EarnshawSam/rpi-cm4-networked-carrier/hardware/rpi-cm4-base-carrier/cm4-base-carrier-brd.pdf

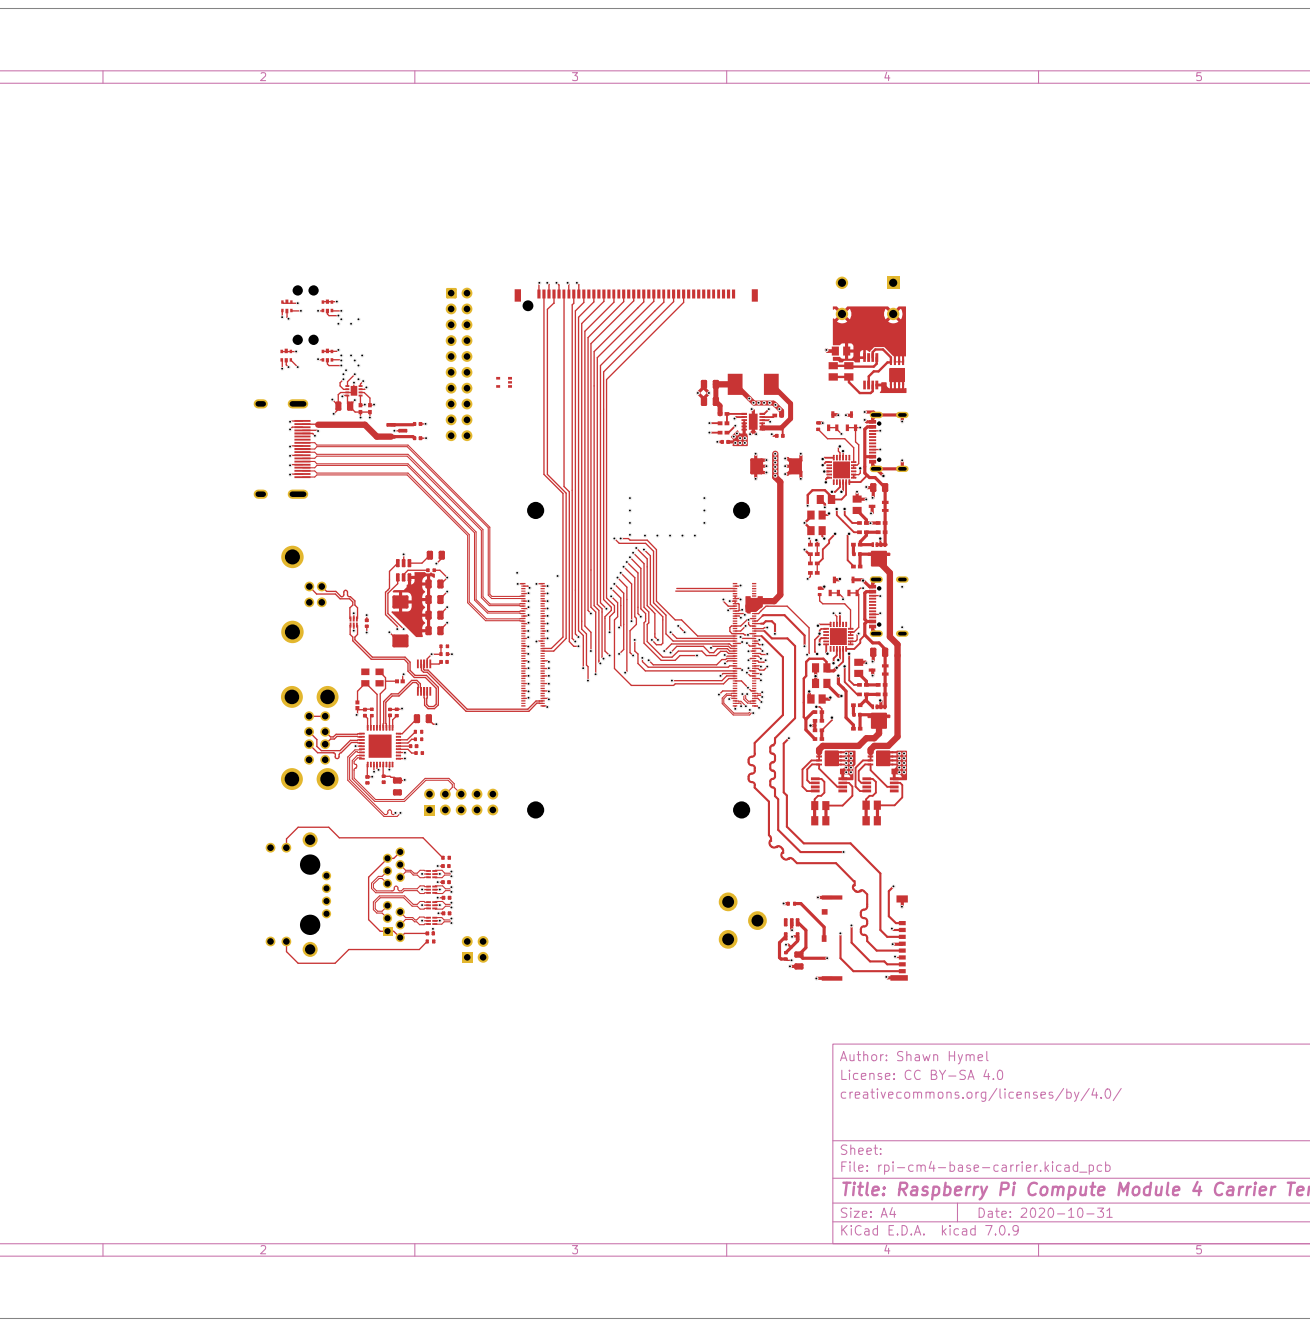
[picture p1: page 1]

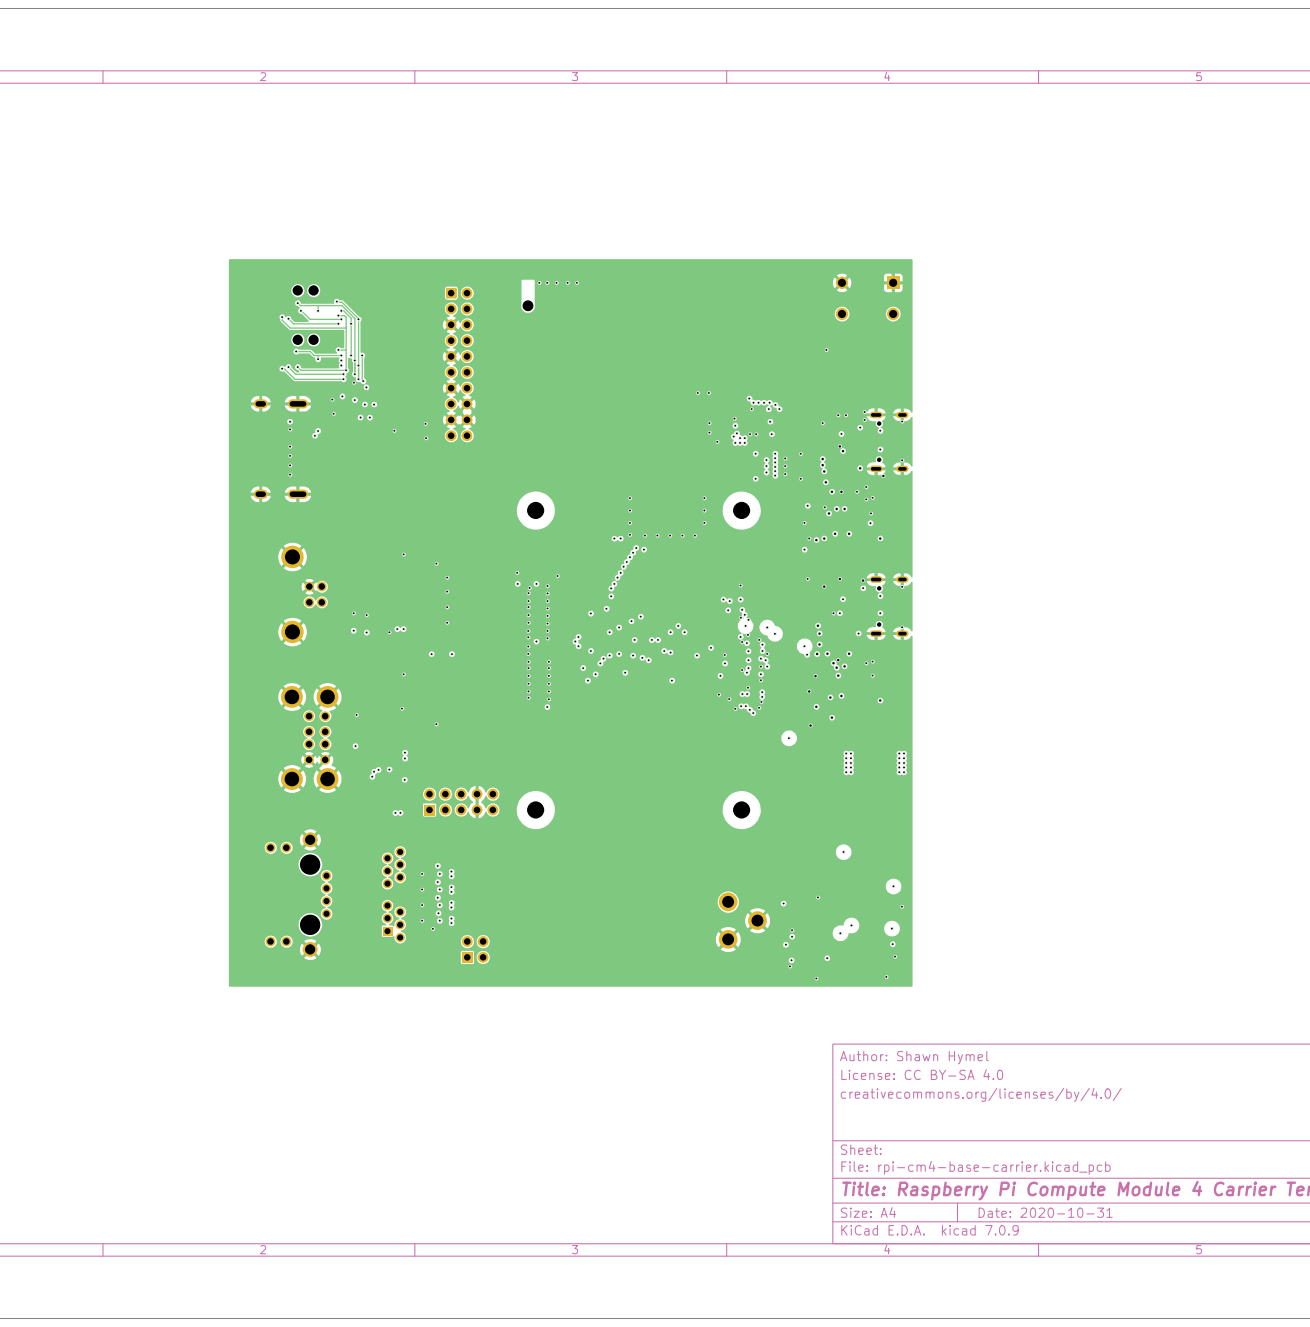
[picture p2: page 2]

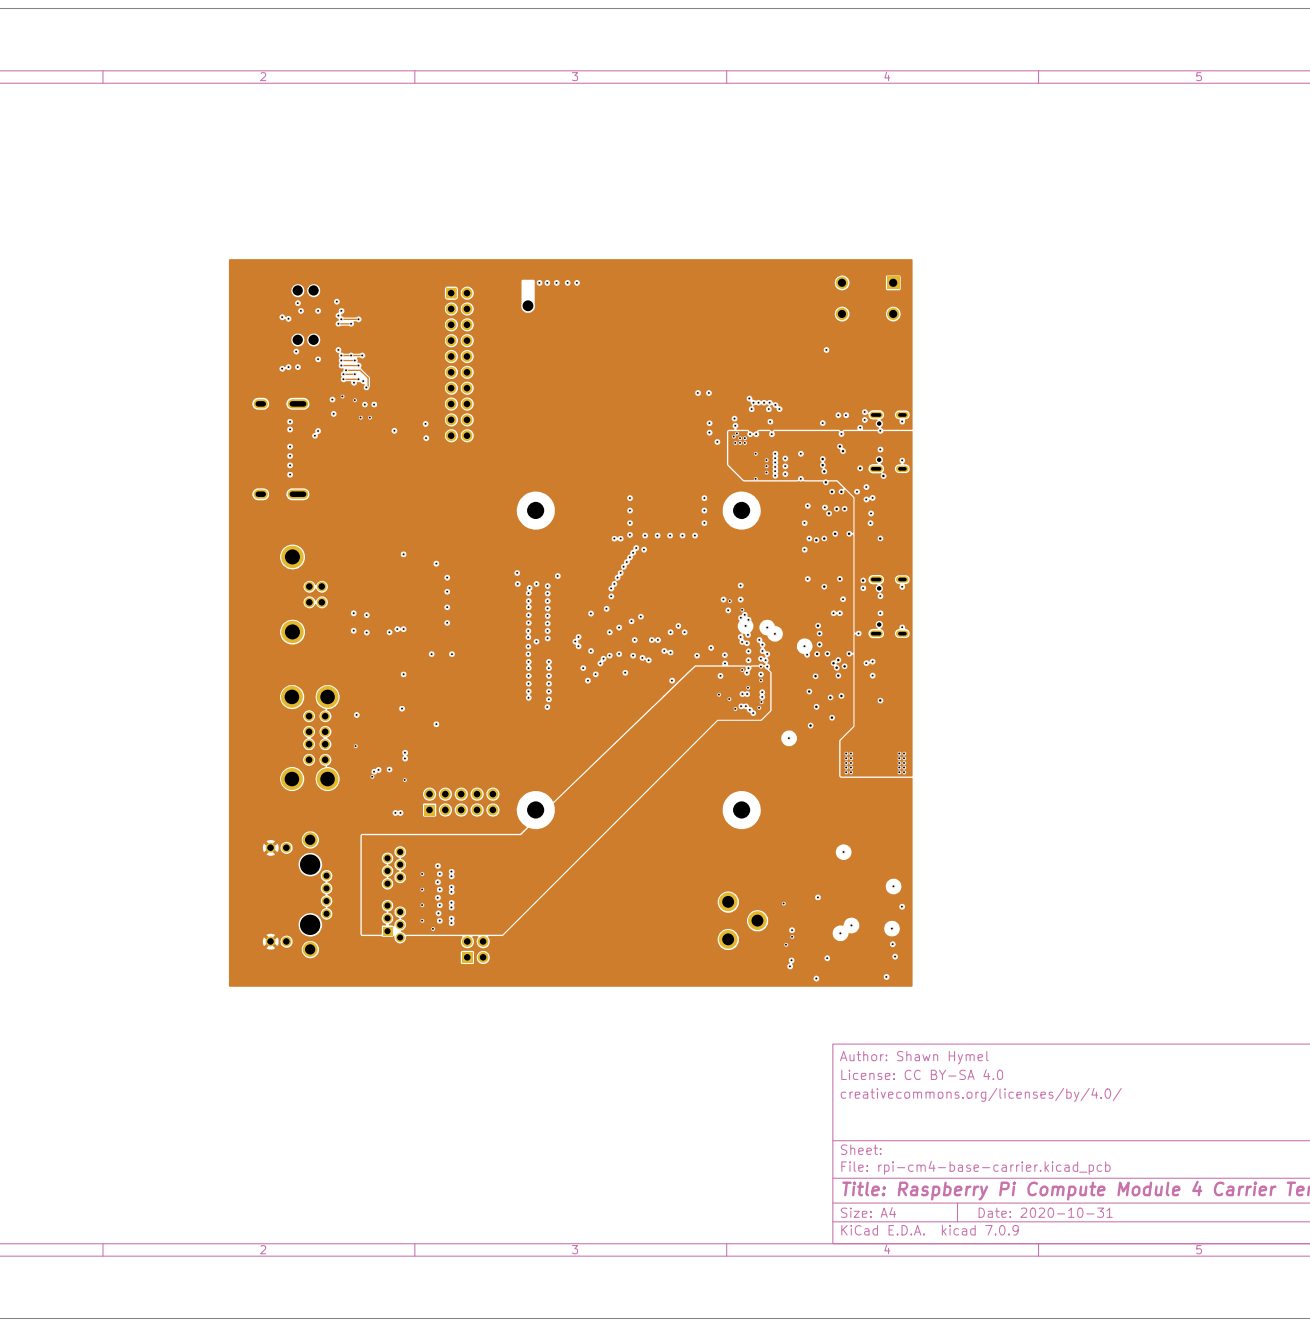
[picture p3: page 3]

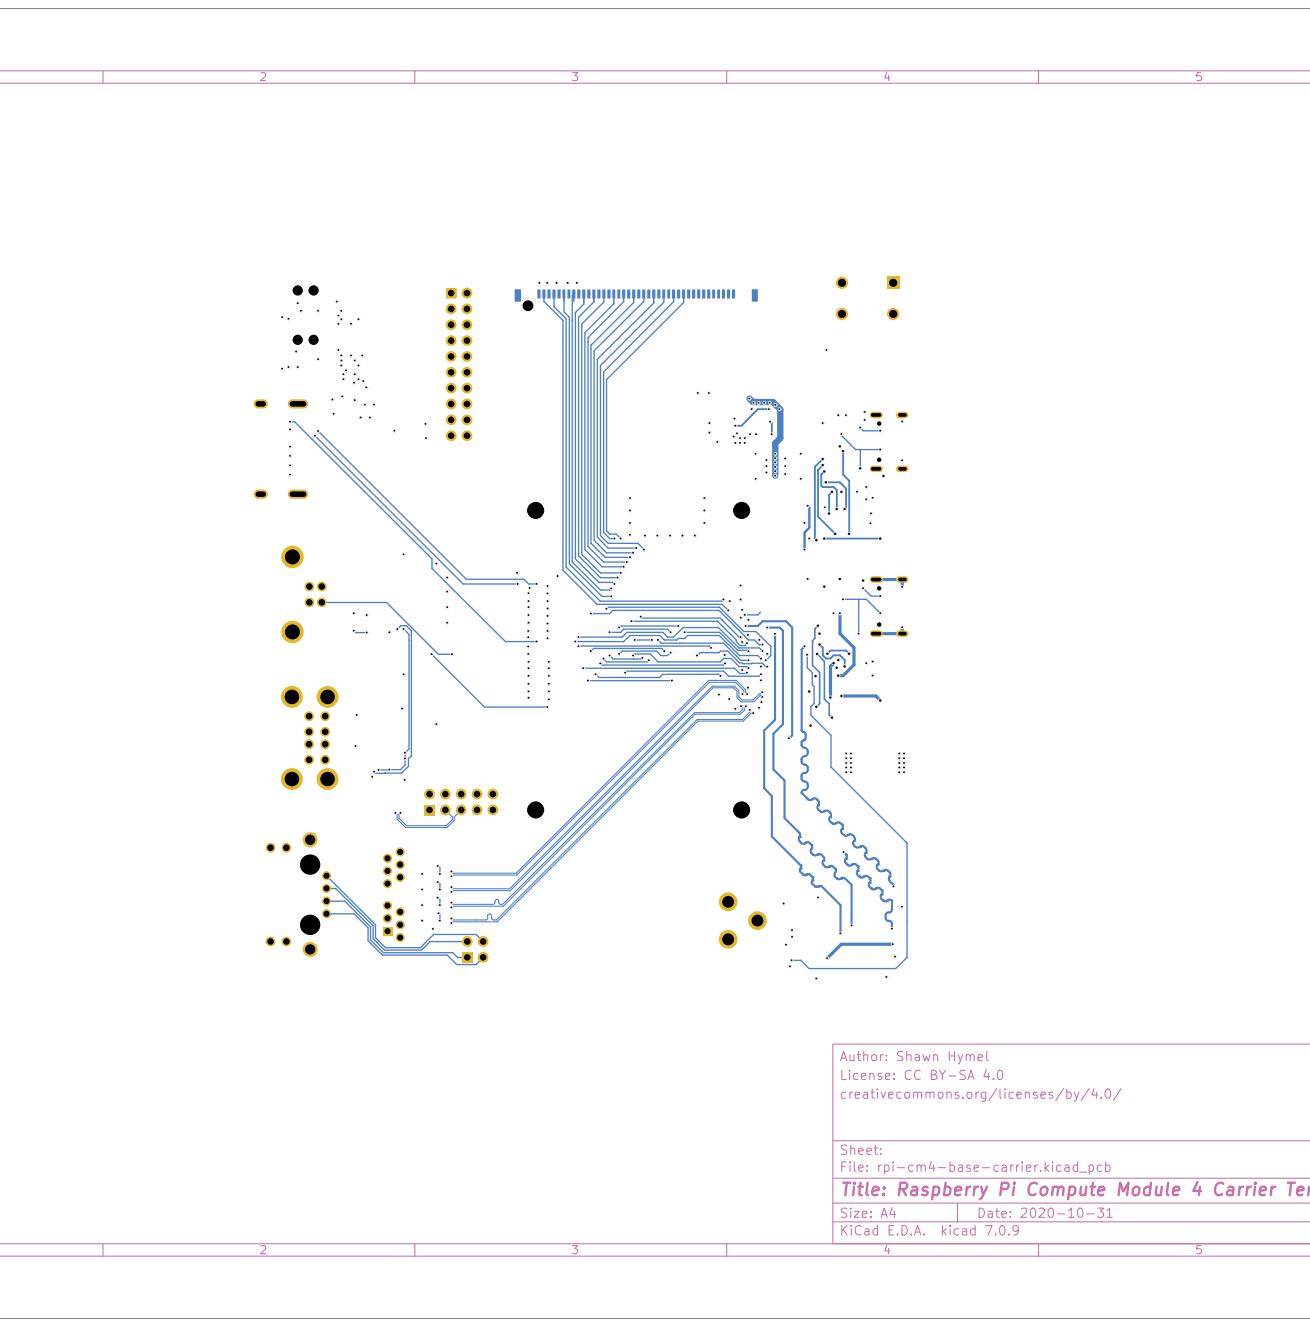
[picture p4: page 4]
