EarnshawSam/rpi-cm4-networked-carrier/hardware/rpi-cm4-base-carrier/rpi-cm4-base-carrier.kicad_pcb

## KiCad design hardware/rpi-cm4-base-carrier/rpi-cm4-base-carrier.kicad_pcb (2024-01-31)

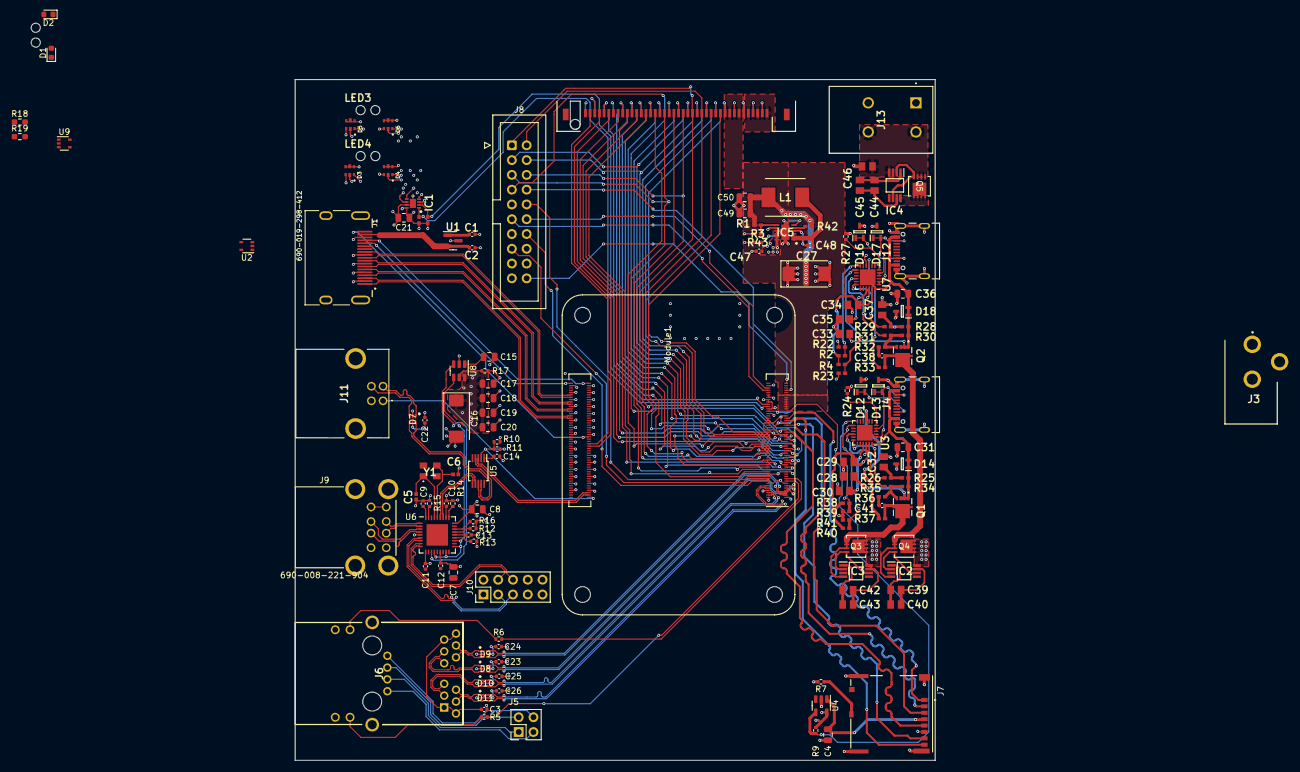
[picture p18: board rpi-cm4-base-carrier.kicad_pcb from above]

Board: 4 copper layers, 110.0 x 117.0 mm, 148 parts (1 on the bottom side), 168 nets.

Parts:
C1, C2, C3, C9, C10, C11, C12, C13, C14, C22, C23, C24, C25, C26, C38, C41, C47, C48: 100n; C_0402_1005Metric
C4, C7, C8, C15, C17, C18, C19, C20, C21, C31, C36, C49, C50: 10u; C_0805_2012Metric
C5, C6: 8pf; CAPC1005X56N
C16, C27: 100uF; CP_EIA-7343-31_Kemet-D
C28, C29, C30, C32, C33, C34, C35, C37, C39, C40, C42, C43, C44, C45, C46: 1u; RESC2012X140N
D1: LED Green; LED_0603_1608Metric
D2: LED Red; LED_0603_1608Metric
D3, D4, D5, D6: 19-337C_RSBHGHC-A88_4T; LED_19-337C_RSBHGHC-A88_4T
D7, D8, D9, D10, D11: USBULC6-2M6; SON50P100X145X60-6N-D
D12, D13, D14, D16, D17, D18: ESDA25W; SOT65P210X110-3N
IC1: KTD2052BEVAA-TR; SON50P200X200X58-9N
IC2, IC3, IC4: LM74610QDGKRQ1; SOP65P490X110-8N
IC5: LMR51450FNDRRR; SON50P300X300X80-13N-D
J1: 690-019-298-412; EDAC 690-019-298-412
J2: ERM8-040-01-X-D-EM2-L-XX; SAMTEC_ERM8-040-01-X-D-EM2-L-XX
J3: PJ-102BH; PJ-102AH
J4, J12: USB4105-GF-A; GCT_USB4105-GF-A
J5: THD-02-R; PinHeader_2x02_P2.54mm_Vertical
J6: JT4-1202HL; JT41202HL
J7: Micro_SD_Card_Det; SDCARD_MOLEX_503398-1892
J8: Conn_02x10_Odd_Even; IDC-Header_2x10_P2.54mm_Vertical
J9: 690-008-221-904; MOLEX_USB_67298-4090
J10: Conn_02x05_Odd_Even; PinHeader_2x05_P2.54mm_Vertical
J11: XM7B-0442; XM7B0442
J13: 1190297
L1: IHLP2525EZER2R2M01-2.2uH; INDPM6965X500N
LED1, LED2, LED3, LED4: 515-1114F
Module1: ComputeModule4-CM4; Raspberry-Pi-4-Compute-Module
Q1, Q2: STL6P3LLH6; TRANS_STL6P3LLH6
Q3, Q4, Q5: STL11N3LLH6; POWERFLAT_3P3X3P3_STM
R1, R30, R34, R42: 100K; RESC1005X40N
R2, R4, R38, R41: NF; RESC1005X40N
R3: 19K1; RESC1005X40N
R5, R6: 470R; R_0402_1005Metric
R7: nf; R_0402_1005Metric
R9, R15, R24, R27: 12K 1%; R_0402_1005Metric
R10, R11: 2.2K 1%; R_0402_1005Metric
R12, R13, R14, R16: 36K 1%; R_0402_1005Metric
R17: 15K 1%; R_0402_1005Metric
R18, R19: 1k; R_0603_1608Metric_Pad0.98x0.95mm_HandSolder
R20, R21: 4K7; RESC1005X37N
R22, R23, R31, R35, R39, R40: 22K; RESC1005X40N
R25, R28: 470R; RESC1005X40N
R26, R29, R33, R37: 1k; RESC1005X37N
R32, R36: 100R; RESC1005X40N
R43: 13K3; RESC1005X40N
U1: RT9742SNGV; SOT-23
U2, U9: 74LVC1G07SE-7; SOT-353_SC-70-5
U3, U7: STUSB4500QTR; QFN-24-1EP_4x4mm_P0.5mm_EP2.7x2.7mm
U4: RT9742GGJ5; SOT-23-5
U5: FSUSB42MUX; MSOP-10_3x3mm_P0.5mm
U6: USB2514B-I/M2; QFN-36-1EP_6x6mm_P0.5mm_EP3.7x3.7mm
U8: AP22653W6; SOT-23-6
Y1: CX3225CA24000D0HSSCC

Connections:
+1V8: Module1.88 (+1.8v_(Output)), Module1.90 (+1.8v_(Output))
+3V3: C7.1, C8.1, C9.1, C10.1, C11.1, C12.1, C13.1, C14.1, C21.1, D1.2 (A), D2.2 (A), IC1.8 (VIN), J2.63, J2.67, J6.18 (A_YELLOW), J6.20 (A_GREEN), Module1.78 (GPIO_VREF(1.8v/3.3v_Input)), Module1.84 (+3.3v_(Output)), Module1.86 (+3.3v_(Output)), R7.1, R9.1, R20.2, R21.2, U4.5 (IN), U5.1 (VCC), U6.5 (VDDA33), U6.10 (VDDA33), U6.15 (VDD33), U6.23 (VDD33), U6.27 (VBUS_DET), U6.29 (VDDA33), U6.36 (VDDA33), U9.5 (VCC)
+5V: C1.1, C15.1, C49.1, C50.1, J2.64, J2.68, L1.2, Module1.77 (+5v_(Input)), Module1.79 (+5v_(Input)), Module1.81 (+5v_(Input)), Module1.83 (+5v_(Input)), Module1.85 (+5v_(Input)), Module1.87 (+5v_(Input)), R1.1, R42.1, U1.1 (IN), U2.5 (VCC), U8.1 (IN)
+20V: C27.1, C47.1, IC2.8 (CATHODE), IC3.8 (CATHODE), IC4.8 (CATHODE), IC5.9 (EN), IC5.10 (VIN_1), IC5.11 (VIN_2), IC5.12 (VIN_3), J2.71, J2.72, J2.75, J2.76, J2.79, J2.80, Q3.5, Q3.6, Q3.7, Q3.8, Q4.5, Q4.6, Q4.7, Q4.8, Q5.5, Q5.6, Q5.7, Q5.8
/Board_Edge_Connector/AIN0: J8.11, Module1.94 (AnalogIP0)
/Board_Edge_Connector/AIN1: J8.12, Module1.96 (AnalogIP1)
/Board_Edge_Connector/EEPROM_nWP: J8.10, Module1.20 (EEPROM_nWP)
/Board_Edge_Connector/GLOBAL_EN: J8.20, Module1.99 (Global_EN)
/Board_Edge_Connector/GPIO2: J2.59, Module1.58 (GPIO2)
/Board_Edge_Connector/GPIO3: J2.60, Module1.56 (GPIO3)
/Board_Edge_Connector/GPIO4: J2.55, Module1.54 (GPIO4)
/Board_Edge_Connector/GPIO5: J2.56, Module1.34 (GPIO5)
/Board_Edge_Connector/GPIO6: J2.51, Module1.30 (GPIO6)
/Board_Edge_Connector/GPIO7: J2.52, J8.2, Module1.37 (GPIO7)
/Board_Edge_Connector/GPIO8: J2.47, J8.4, Module1.39 (GPIO8)
/Board_Edge_Connector/GPIO9: J2.48, J8.1, Module1.40 (GPIO9)
/Board_Edge_Connector/GPIO10: J2.43, J8.3, Module1.44 (GPIO10)
/Board_Edge_Connector/GPIO11: J2.44, J8.6, Module1.38 (GPIO11)
/Board_Edge_Connector/GPIO12: J2.39, Module1.31 (GPIO12)
/Board_Edge_Connector/GPIO13: J2.40, Module1.28 (GPIO13)
/Board_Edge_Connector/GPIO14: J2.35, J8.7, Module1.55 (GPIO14)
/Board_Edge_Connector/GPIO15: J2.36, J8.5, Module1.51 (GPIO15)
/Board_Edge_Connector/GPIO16: J2.31, Module1.29 (GPIO16)
/Board_Edge_Connector/GPIO17: J2.32, Module1.50 (GPIO17)
/Board_Edge_Connector/GPIO18: J2.27, Module1.49 (GPIO18)
/Board_Edge_Connector/GPIO19: J2.28, Module1.26 (GPIO19)
/Board_Edge_Connector/GPIO20: J2.23, Module1.27 (GPIO20)
/Board_Edge_Connector/GPIO21: J2.24, Module1.25 (GPIO21)
/Board_Edge_Connector/GPIO22: J2.19, Module1.46 (GPIO22)
/Board_Edge_Connector/GPIO23: J2.20, Module1.47 (GPIO23)
/Board_Edge_Connector/GPIO24: J2.15, Module1.45 (GPIO24)
/Board_Edge_Connector/GPIO25: J2.16, Module1.41 (GPIO25)
/Board_Edge_Connector/GPIO26: J2.11, Module1.24 (GPIO26)
/Board_Edge_Connector/GPIO27: J2.12, Module1.48 (GPIO27)
/Board_Edge_Connector/HDMI1_SCL: J2.04, Module1.147 (HDMI1_SCL)
/Board_Edge_Connector/HDMI1_SDA: J2.08, Module1.145 (HDMI1_SDA)
/Board_Edge_Connector/RUN_PG: Module1.92 (RUN_PG), U2.2
/Board_Edge_Connector/SYNC_IN: J8.14, Module1.16 (Ethernet_SYNC_IN(1.8v))
/Board_Edge_Connector/SYNC_OUT: J8.15, Module1.18 (Ethernet_SYNC_OUT(1.8v))
/Board_Edge_Connector/nRPIBOOT: J8.8, Module1.93 (nRPIBOOT)
/CM4 GPIO/ETH_LEDG: Module1.17 (Ethernet_nLED2(3.3v)), R6.2
/CM4 GPIO/ETH_LEDY: Module1.15 (Ethernet_nLED3(3.3v)), R5.2
/CM4 GPIO/LEDs/RGB1: D3.5, D4.3, D5.1, D6.2, D6.4, D6.6, IC1.6 (LED1)
/CM4 GPIO/LEDs/RGB2: D3.3, D4.1, D5.2, D5.4, D5.6, D6.5, IC1.5 (LED2)
/CM4 GPIO/LEDs/RGB3: D3.1, D4.2, D4.4, D4.6, D5.5, D6.3, IC1.3 (LED4)
/CM4 GPIO/LEDs/RGB4: D3.2, D3.4, D3.6, D4.5, D5.3, D6.1, IC1.4 (LED3)
/CM4 GPIO/SCL0: IC1.1 (SCL), J2.03, Module1.80 (SCL0), R20.1, U3.7 (SCL), U7.7 (SCL)
/CM4 GPIO/SDA0: IC1.2 (SDA), J2.07, Module1.82 (SDA0), R21.1, U3.8 (SDA), U7.8 (SDA)
/CM4 GPIO/SD_CLK: J7.5 (CLK), Module1.57 (SD_CLK)
/CM4 GPIO/SD_CMD: J7.3 (CMD), Module1.62 (SD_CMD)
/CM4 GPIO/SD_DAT0: J7.7 (DAT0), Module1.63 (SD_DAT0)
/CM4 GPIO/SD_DAT1: J7.8 (DAT1), Module1.67 (SD_DAT1)
/CM4 GPIO/SD_DAT2: J7.1 (DAT2), Module1.69 (SD_DAT2)
/CM4 GPIO/SD_DAT3: J7.2 (DAT3/CD), Module1.61 (SD_DAT3)
/CM4 GPIO/SD_PWR_ON: Module1.75 (SD_PWR_ON), R9.2, U4.4 (EN)
/CM4 GPIO/TRD0_N: D11.1 (D+), D11.6 (I/O1), J6.9 (TRD1-), Module1.10 (Ethernet_Pair0_N)
/CM4 GPIO/TRD0_P: D11.3 (D-), D11.4 (I/O2), J6.8 (TRD1+), Module1.12 (Ethernet_Pair0_P)
/CM4 GPIO/TRD1_N: D10.3 (D-), D10.4 (I/O2), J6.3 (TRD2-), Module1.6 (Ethernet_Pair1_N)
/CM4 GPIO/TRD1_P: D10.1 (D+), D10.6 (I/O1), J6.2 (TRD2+), Module1.4 (Ethernet_Pair1_P)
/CM4 GPIO/TRD2_N: D8.3 (D-), D8.4 (I/O2), J6.5 (TRD3-), Module1.9 (Ethernet_Pair2_N)
/CM4 GPIO/TRD2_P: D8.1 (D+), D8.6 (I/O1), J6.4 (TRD3+), Module1.11 (Ethernet_Pair2_P)
/CM4 GPIO/TRD3_N: D9.1 (D+), D9.6 (I/O1), J6.11 (TRD4-), Module1.5 (Ethernet_Pair3_N)
/CM4 GPIO/TRD3_P: D9.3 (D-), D9.4 (I/O2), J6.10 (TRD4+), Module1.3 (Ethernet_Pair3_P)
/CM4 GPIO/nLED_Activity: Module1.21 (PI_nLED_Activity), R18.2
/CM4 GPIO/nPWR_LED: Module1.95 (nPI_LED_PWR), U9.2
/CM4 High Speed/HDMI0_CK_N: J1.12 (CK-), Module1.190 (HDMI0_CLK_N)
/CM4 High Speed/HDMI0_CK_P: J1.10 (CK+), Module1.188 (HDMI0_CLK_P)
/CM4 High Speed/HDMI0_D0_N: J1.9 (D0-), Module1.184 (HDMI0_TX0_N)
/CM4 High Speed/HDMI0_D0_P: J1.7 (D0+), Module1.182 (HDMI0_TX0_P)
/CM4 High Speed/HDMI0_D1_N: J1.6 (D1-), Module1.178 (HDMI0_TX1_N)
/CM4 High Speed/HDMI0_D1_P: J1.4 (D1+), Module1.176 (HDMI0_TX1_P)
/CM4 High Speed/HDMI0_D2_N: J1.3 (D2-), Module1.172 (HDMI0_TX2_N)
/CM4 High Speed/HDMI0_D2_P: J1.1 (D2+), Module1.170 (HDMI0_TX2_P)
/CM4 High Speed/HDMI0_HOTPLUG: J1.19 (HPD/HEAC-), Module1.153 (HDMI0_HOTPLUG)
/CM4 High Speed/HDMI0_SCL: J1.15 (SCL), Module1.200 (HDMI0_SCL)
/CM4 High Speed/HDMI0_SDA: J1.16 (SDA), Module1.199 (HDMI0_SDA)
/CM4 High Speed/HDMI/HDMI_5v: C2.1, J1.18 (+5V), U1.2 (OUT)
/CM4 High Speed/USB2-HUB/HD1_N: J9.2 (D-`), U6.1 (USBDM_DN1/PRT_DIS_M1)
/CM4 High Speed/USB2-HUB/HD1_P: J9.3 (D+`), U6.2 (USBDP_DN1/PRT_DIS_P1)
/CM4 High Speed/USB2-HUB/HD2_N: J9.6 (D-), U6.3 (USBDM_DN2/PRT_DIS_M2)
/CM4 High Speed/USB2-HUB/HD2_P: J9.7 (D+), U6.4 (USBDP_DN2/PRT_DIS_P2)
/CM4 High Speed/USB2-HUB/HD3_N: J10.3, U6.6 (USBDM_DN3/PRT_DIS_M3)
/CM4 High Speed/USB2-HUB/HD3_P: J10.5, U6.7 (USBDP_DN3/PRT_DIS_P3)
/CM4 High Speed/USB2-HUB/HD4_N: J10.4, U6.8 (USBDM_DN4/PRT_DIS_M4)
/CM4 High Speed/USB2-HUB/HD4_P: J10.6, U6.9 (USBDP_DN4/PRT_DIS_P4)
/CM4 High Speed/USB2-HUB/PWR1: U6.12 (PRTPWR1/BC_EN1), U8.3 (EN)
/CM4 High Speed/USB2-HUB/USBD_N: D7.1 (D+), D7.6 (I/O1), J11.2, U5.8 (HSD1_M)
/CM4 High Speed/USB2-HUB/USBH_N: U5.6 (HSD0_M), U6.30 (USBDM_UP)
/CM4 High Speed/USB2-HUB/USBH_P: U5.7 (HSD0_P), U6.31 (USBDP_UP)
/CM4 High Speed/USB2-HUB/VBUS: C16.1, C17.1, C18.1, C19.1, C20.1, J9.1 (VBUS`), J9.5 (VBUS), J10.1, J10.2, U8.6 (OUT)
/CM4 High Speed/USB2-HUB/nEXTRST: Module1.100 (nEXTRST), U6.26 (RESET_N)
/CM4 High Speed/USB2-HUB/nOCS1: U6.13 (OCS_N1), U6.17 (OCS_N2), U6.19 (OCS_N3), U6.21 (OCS_N4), U8.4 (nFault)
/CM4 High Speed/USB2_N: Module1.103 (USB2_N), U5.4 (D_N)
/CM4 High Speed/USB2_P: Module1.105 (USB2_P), U5.3 (D_P)
/CM4 High Speed/USB_OTG_ID: Module1.101 (USB_OTG_ID), R10.1, R11.2, U5.2 (SEL)
/Power_Input/AUX_20V: C46.1, IC4.4 (ANODE), J3.1, J13.3 (2.1), J13.4 (2.2), Q5.1, Q5.2, Q5.3
/Power_Input/USBC_PWR.Sheet1/+2V7: C29.1, R38.1, R40.1, U3.23 (VREG_2V7)
/Power_Input/USBC_PWR.Sheet1/ADDR0: R38.2, R39.1, U3.12 (ADDR0)
/Power_Input/USBC_PWR.Sheet1/ADDR1: R40.2, R41.1, U3.13 (ADDR1)
/Power_Input/USBC_PWR.Sheet1/CC1: D12.1 (CATHODE_1), D12.2 (CATHODE_2), J4.A5 (CC1), U3.1 (CC1DB), U3.2 (CC1)
/Power_Input/USBC_PWR.Sheet1/CC2: D13.1 (CATHODE_1), D13.2 (CATHODE_2), J4.B5 (CC2), U3.4 (CC2), U3.5 (CC2DB)
/Power_Input/USBC_PWR.Sheet1/V_SINK: C41.1, IC3.4 (ANODE), Q1.5_8 (5), Q3.1, Q3.2, Q3.3, R37.1
/Power_Input/USBC_PWR.Sheet/+2V7: C34.1, R2.1, R4.1, U7.23 (VREG_2V7)
/Power_Input/USBC_PWR.Sheet/ADDR0: R2.2, R22.1, U7.12 (ADDR0)
/Power_Input/USBC_PWR.Sheet/ADDR1: R4.2, R23.1, U7.13 (ADDR1)
/Power_Input/USBC_PWR.Sheet/CC1: D16.1 (CATHODE_1), D16.2 (CATHODE_2), J12.A5 (CC1), U7.1 (CC1DB), U7.2 (CC1)
/Power_Input/USBC_PWR.Sheet/CC2: D17.1 (CATHODE_1), D17.2 (CATHODE_2), J12.B5 (CC2), U7.4 (CC2), U7.5 (CC2DB)
/Power_Input/USBC_PWR.Sheet/V_SINK: C38.1, IC2.4 (ANODE), Q2.5_8 (5), Q4.1, Q4.2, Q4.3, R33.1
/SDCard/SD_PWR: C4.1, J7.4 (VDD), U4.1 (OUT)
/magjack/TR0_TAP: J5.3, J6.13 (TRP1)
/magjack/TR1_TAP: J5.1, J6.14 (TRP2)
/magjack/TR2_TAP: J5.2, J6.15 (TRP3)
/magjack/TR3_TAP: J5.4, J6.16 (TRP4)
/magjack/TRCT: C3.1, J6.1 (TRCT2), J6.6 (TRCT3), J6.7 (TRCT1), J6.12 (TRCT4)
GND: C1.2, C2.2, C3.2, C4.2, C5.2, C6.2, C7.2, C8.2, C9.2, C10.2, C11.2, C12.2, C13.2, C14.2, C15.2, C16.2, C17.2, C18.2, C19.2, C20.2, C21.2, C22.2, C23.2, C24.2, C25.2, C26.2, C27.2, C28.2, C29.2, C30.2, C31.2, C32.2, C33.2, C34.2, C35.2, C36.2, C37.2, C46.2, C47.2, C49.2, C50.2, D7.2 (GND_1), D7.4 (I/O2), D8.2 (GND_1), D9.2 (GND_1), D10.2 (GND_1), D11.2 (GND_1), D12.3 (ANODE), D13.3 (ANODE), D14.3 (ANODE), D16.3 (ANODE), D17.3 (ANODE), D18.3 (ANODE), IC1.7 (GND), IC1.9 (EP), IC5.8 (AGND), IC5.13 (PGND/DAP), J1.2 (D2S), J1.5 (D1S), J1.8 (D0S), J1.11 (CKS), J1.17 (GND), J1.SH1 (SH), J1.SH2 (SH), J1.SH3 (SH), J1.SH4 (SH), J2.01, J2.02, J2.05, J2.06, J2.09, J2.10, J2.13, J2.14, J2.17, J2.18, J2.21, J2.22, J2.25, J2.26, J2.29, J2.30, J2.33, J2.34, J2.37, J2.38, J2.41, J2.42, J2.45, J2.46, J2.49, J2.50, J2.53, J2.54, J2.57, J2.58, J2.61, J2.62, J2.65, J2.66, J2.69, J2.70, J2.73, J2.74, J2.77, J2.78, J3.2, J3.3, J4.A1/B12 (GND), J4.B1/A12 (GND), J4.G1 (GND), J4.G2 (GND), J4.G3 (GND), J4.G4 (GND), J6.MH3, J6.MH4, J7.6 (VSS), J7.11 (SHIELD), J8.9, J8.13, J8.16, J8.17, J8.18, J9.4 (GND`), J9.8 (GND), J9.MT1, J9.MT2, J9.MT3, J9.MT4, J10.7, J10.8, J11.3, J11.MH1, J11.MH2, J12.A1/B12 (GND), J12.B1/A12 (GND), J12.G1 (GND), J12.G2 (GND), J12.G3 (GND), J12.G4 (GND), J13.1 (1.1), J13.2 (1.2), Module1.1 (GND), Module1.2 (GND), Module1.7 (GND), Module1.8 (GND), Module1.13 (GND), Module1.14 (GND), Module1.22 (GND), Module1.23 (GND), Module1.32 (GND), Module1.33 (GND), Module1.42 (GND), Module1.43 (GND), Module1.52 (GND), Module1.53 (GND), Module1.59 (GND), Module1.60 (GND), Module1.65 (GND), Module1.66 (GND), Module1.71 (GND), Module1.74 (GND), Module1.98 (GND), Module1.107 (GND), Module1.108 (GND), Module1.113 (GND), Module1.114 (GND), Module1.119 (GND), Module1.120 (GND), Module1.125 (GND), Module1.126 (GND), Module1.131 (GND), Module1.132 (GND), Module1.137 (GND), Module1.138 (GND), Module1.144 (GND), Module1.150 (GND), Module1.155 (GND), Module1.156 (GND), Module1.161 (GND), Module1.162 (GND), Module1.167 (GND), Module1.168 (GND), Module1.173 (GND), Module1.174 (GND), Module1.179 (GND), Module1.180 (GND), Module1.185 (GND), Module1.186 (GND), Module1.191 (GND), Module1.192 (GND), Module1.197 (GND), Module1.198 (GND), R3.1, R10.2, R12.2, R13.2, R14.2, R15.1, R16.2, R17.2, R22.2, R23.2, R24.1, R27.1, R39.2, R41.2, R43.1, U1.3 (GND), U2.3 (GND), U3.10 (GND), U3.22 (VSYS), U3.25 (GND), U4.2 (GND), U5.5 (GND), U5.9 (HSD1_P), U5.10 (nOE), U6.37 (VSS), U7.10 (GND), U7.22 (VSYS), U7.25 (GND), U8.2 (GND), U9.3 (GND)
unnamed: C32.1, R25.2, R26.1
unnamed: C37.1, R28.2, R29.1
unnamed: C38.2, R32.2
unnamed: C41.2, R36.2
unnamed: D1.1 (K), R18.1
unnamed: D2.1 (K), R19.1
unnamed: C22.1, D7.5 (GND_2)
unnamed: C23.1, D8.5 (GND_2)
unnamed: C24.1, D9.5 (GND_2)
unnamed: C25.1, D10.5 (GND_2)
unnamed: C26.1, D11.5 (GND_2)
unnamed: C28.1, C31.1, D14.1 (CATHODE_1), D14.2 (CATHODE_2), J4.A4/B9 (VBUS), J4.B4/A9 (VBUS), Q1.1, Q1.2, Q1.3, R25.1, R34.1, U3.24 (VDD)
unnamed: C33.1, C36.1, D18.1 (CATHODE_1), D18.2 (CATHODE_2), J12.A4/B9 (VBUS), J12.B4/A9 (VBUS), Q2.1, Q2.2, Q2.3, R28.1, R30.1, U7.24 (VDD)
unnamed: IC2.2 (GATE_PULL_DOWN), IC2.6 (GATE_DRIVE), Q4.4
unnamed: C39.2, C40.2, IC2.7 (VCAPH)
unnamed: C39.1, C40.1, IC2.1 (VCAPL)
unnamed: IC3.2 (GATE_PULL_DOWN), IC3.6 (GATE_DRIVE), Q3.4
unnamed: C42.2, C43.2, IC3.7 (VCAPH)
unnamed: C42.1, C43.1, IC3.1 (VCAPL)
unnamed: IC4.2 (GATE_PULL_DOWN), IC4.6 (GATE_DRIVE), Q5.4
unnamed: C44.2, C45.2, IC4.7 (VCAPH)
unnamed: C44.1, C45.1, IC4.1 (VCAPL)
unnamed: C48.1, IC5.4 (BOOT)
unnamed: IC5.7 (FB), R1.2, R3.2
unnamed: IC5.5 (PG), R42.2
unnamed: IC5.6 (RT), R43.2
unnamed: C48.2, IC5.1 (SW_1), IC5.2 (SW_2), IC5.3 (SW_3), L1.1
unnamed: J6.19 (K_GREEN), R6.1
unnamed: J6.17 (K_YELLOW), R5.1
unnamed: J7.10 (DET_A), R7.2
unnamed: J8.19, U2.4
unnamed: J11.1, R11.1
unnamed: Q1.4, R34.2, R35.1, R36.1
unnamed: Q2.4, R30.2, R31.1, R32.1
unnamed: R19.2, U9.4
unnamed: R37.2, U3.9 (DISCH)
unnamed: R24.2, U3.6 (RESET)
unnamed: R35.2, U3.16 (VBUS_EN_SNK)
unnamed: R26.2, U3.18 (VBUS_VS_DISCH)
unnamed: C30.1, U3.21 (VREG_1V2)
unnamed: R16.1, U6.25 (HS_IND/CFG_SEL1)
unnamed: R15.2, U6.35 (RBIAS)
unnamed: R12.1, U6.24 (SCL/SMBCLK/CFG_SEL0)
unnamed: R13.1, U6.22 (SDA/SMBDATA/NON_REM1)
unnamed: R14.1, U6.28 (SUSP_IND/LOCAL_PWR/NON_REM0)
unnamed: C5.1, U6.33 (XTALIN/CLKIN), Y1.1 (HOT_1)
unnamed: C6.1, U6.32 (XTALOUT), Y1.3 (HOT_2)
unnamed: R33.2, U7.9 (DISCH)
unnamed: R27.2, U7.6 (RESET)
unnamed: R31.2, U7.16 (VBUS_EN_SNK)
unnamed: R29.2, U7.18 (VBUS_VS_DISCH)
unnamed: C35.1, U7.21 (VREG_1V2)
unnamed: R17.1, U8.5 (ILIM)
