EarnshawSam/rpi-cm4-networked-carrier/hardware/rpi-cm4-base-carrier/rpi-cm4-base-carrier - Backup.kicad_pcb

## KiCad design hardware/rpi-cm4-base-carrier/rpi-cm4-base-carrier - Backup.kicad_pcb (2024-01-14)

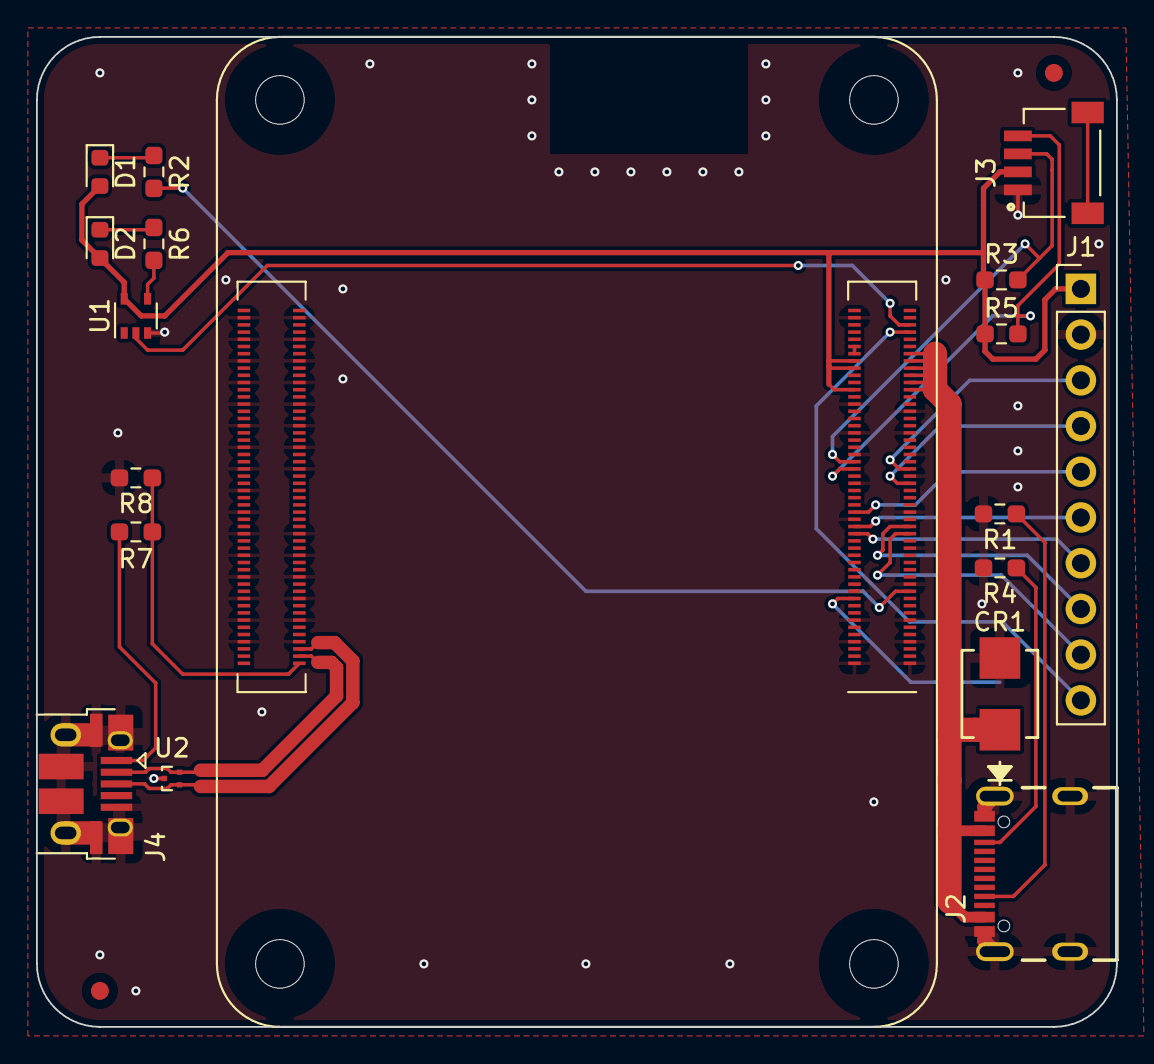
[picture p19: board rpi-cm4-base-carrier - Backup.kicad_pcb from above]

Board: 2 copper layers, 60.0 x 55.0 mm, 19 parts (1 on the bottom side), 27 nets.

Parts:
CR1: SMBJ5.0A-TR
D1: LED Green; LED_0603_1608Metric
D2: LED Red; LED_0603_1608Metric
J1: DNP; PinHeader_1x10_P2.54mm_Vertical
J2: USB4105-GF-A; GCT_USB4105-GF-A
J3: SM04B-SRSS-TB(LF)(SN); JST_SM04B-SRSS-TB(LF)(SN)
J4: USB_OTG; USB_Micro-B_EDAC_UCON00686
JP1: SolderJumper_2_Open; SolderJumper-2_P1.3mm_Open_RoundedPad1.0x1.5mm
Module1: ComputeModule4-CM4; Raspberry-Pi-4-Compute-Module
R1, R4: 5.1k; R_0603_1608Metric_Pad0.98x0.95mm_HandSolder
R2, R6: 1k; R_0603_1608Metric_Pad0.98x0.95mm_HandSolder
R3, R5: DNP; R_0603_1608Metric_Pad0.98x0.95mm_HandSolder
R7, R8: 2.2K 1%; R_0603_1608Metric_Pad0.98x0.95mm_HandSolder
U1: 74LVC1G07SE-7; SOT-353_SC-70-5
U2: TPD2EUSB30; Texas_DRT-3

Connections:
+1.8V: Module1.88 (+1.8v_(Output)), Module1.90 (+1.8v_(Output))
+3.3V: D1.2 (A), D2.2 (A), J1.1, J3.2, Module1.78 (GPIO_VREF(1.8v/3.3v_Input)), Module1.84 (+3.3v_(Output)), Module1.86 (+3.3v_(Output)), R3.1, R5.1, U1.5 (VCC)
+5V: CR1.1, J2.A4/B9 (VBUS), J2.B4/A9 (VBUS), Module1.77 (+5v_(Input)), Module1.79 (+5v_(Input)), Module1.81 (+5v_(Input)), Module1.83 (+5v_(Input)), Module1.85 (+5v_(Input)), Module1.87 (+5v_(Input))
/CM4 GPIO/EEPROM_nWP: JP1.1 (A), Module1.20 (EEPROM_nWP)
/CM4 GPIO/GPIO2: J3.3, Module1.58 (GPIO2), R3.2
/CM4 GPIO/GPIO3: J3.4, Module1.56 (GPIO3), R5.2
/CM4 GPIO/GPIO7: J1.9, Module1.37 (GPIO7)
/CM4 GPIO/GPIO8: J1.8, Module1.39 (GPIO8)
/CM4 GPIO/GPIO9: J1.6, Module1.40 (GPIO9)
/CM4 GPIO/GPIO10: J1.5, Module1.44 (GPIO10)
/CM4 GPIO/GPIO11: J1.7, Module1.38 (GPIO11)
/CM4 GPIO/GPIO14: J1.3, Module1.55 (GPIO14)
/CM4 GPIO/GPIO15: J1.4, Module1.51 (GPIO15)
/CM4 GPIO/nLED_Activity: Module1.21 (PI_nLED_Activity), R2.2
/CM4 GPIO/nPWR_LED: Module1.95 (nPI_LED_PWR), U1.2
/CM4 GPIO/nRPIBOOT: J1.10, Module1.93 (nRPIBOOT)
/CM4 High Speed/USB2_N: J4.2 (D-), Module1.103 (USB2_N), U2.2 (D-)
/CM4 High Speed/USB2_P: J4.3 (D+), Module1.105 (USB2_P), U2.1 (D+)
/CM4 High Speed/USB_OTG_ID: Module1.101 (USB_OTG_ID), R7.2, R8.1
GND: CR1.2, J1.2, J2.A1/B12 (GND), J2.B1/A12 (GND), J2.G1 (GND), J2.G2 (GND), J2.G3 (GND), J2.G4 (GND), J3.1, J4.5 (GND), J4.6 (Shield), JP1.2 (B), Module1.1 (GND), Module1.2 (GND), Module1.7 (GND), Module1.8 (GND), Module1.13 (GND), Module1.14 (GND), Module1.22 (GND), Module1.23 (GND), Module1.32 (GND), Module1.33 (GND), Module1.42 (GND), Module1.43 (GND), Module1.52 (GND), Module1.53 (GND), Module1.59 (GND), Module1.60 (GND), Module1.65 (GND), Module1.66 (GND), Module1.71 (GND), Module1.74 (GND), Module1.98 (GND), Module1.107 (GND), Module1.108 (GND), Module1.113 (GND), Module1.114 (GND), Module1.119 (GND), Module1.120 (GND), Module1.125 (GND), Module1.126 (GND), Module1.131 (GND), Module1.132 (GND), Module1.137 (GND), Module1.138 (GND), Module1.144 (GND), Module1.150 (GND), Module1.155 (GND), Module1.156 (GND), Module1.161 (GND), Module1.162 (GND), Module1.167 (GND), Module1.168 (GND), Module1.173 (GND), Module1.174 (GND), Module1.179 (GND), Module1.180 (GND), Module1.185 (GND), Module1.186 (GND), Module1.191 (GND), Module1.192 (GND), Module1.197 (GND), Module1.198 (GND), R1.2, R4.2, R8.2, U1.3 (GND), U2.3 (GND)
unnamed: D1.1 (K), R2.1
unnamed: D2.1 (K), R6.1
unnamed: J2.A5 (CC1), R1.1
unnamed: J2.B5 (CC2), R4.1
unnamed: J3.S1 (SHIELD), J3.S2 (SHIELD)
unnamed: J4.1 (VBUS), R7.1
unnamed: R6.2, U1.4
