EarnshawSam/rpi-cm4-networked-carrier/(commit log)

2024-01-13 schematic changes to add network, hdmi, usbhost and SD
    [HDMI.kicad_sch, SDCard.kicad_sch, USB2-HUB.kicad_sch, cm4-gpio.kicad_sch, cm4-high-speed.kicad_sch, magjack.kicad_sch, rpi-cm4-base-carrier.kicad_sch]
2024-01-14 routing for some modules progressing quickly, USBHUB mostly complete, thought needed regarding which connectors should be exposed post assembly and which should be for internal use only. LED identifi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
    [HDMI.kicad_sch, SDCard.kicad_sch, USB2-HUB.kicad_sch, cm4-gpio.kicad_sch, cm4-high-speed.kicad_sch, magjack.kicad_sch, rpi-cm4-base-carrier - Backup.kicad_pcb, usb-pd.kicad_sch]
2024-01-15 addition of 4xRGB LED's and I2C driver, also includes right angle lightpipe
    [LEDs.kicad_sch, cm4-gpio.kicad_sch, rpi-cm4-base-carrier.kicad_pcb]
2024-01-16 started final placement of blocks, realised ESD suppression devices cannot be manufactured with JLC, need to switch part
    [LEDs.kicad_sch, SDCard.kicad_sch, USB2-HUB.kicad_sch, cm4-gpio.kicad_sch, cm4-high-speed.kicad_sch, magjack.kicad_sch, rpi-cm4-base-carrier.kicad_pcb]
2024-01-19 started to route core connectors to CM4, RJ45 annoyingly has the inverse pinout to CM4, need to work out how to uncross tracking sensibly
    [USB2-HUB.kicad_sch, cm4-gpio.kicad_sch, magjack.kicad_sch, rpi-cm4-base-carrier.kicad_pcb]
2024-01-21 most diff pairs routed, forgot about intra-pair spacing
    [HDMI.kicad_sch, cm4-high-speed.kicad_sch, rpi-cm4-base-carrier.kicad_pcb]
2024-01-22 schematic entry for samtec board edge connector complete, started breakout of GPIO lines for connection to board edge connector
    [Board_Edge_Connector.kicad_sch, SDCard.kicad_sch, USB2-HUB.kicad_sch, cm4-gpio.kicad_sch, cm4-high-speed.kicad_sch, magjack.kicad_sch, rpi-cm4-base-carrier.kicad_pcb, rpi-cm4-base-carrier.kicad_sch]
2024-01-23 board edge connector mostly connected
    [Board_Edge_Connector.kicad_sch, cm4-gpio.kicad_sch, rpi-cm4-base-carrier.kicad_pcb]
2024-01-28 redundant USBC power schematic created, layout of single USBC input completed@
    [cm4-gpio.kicad_sch, pwr_input.kicad_sch, rpi-cm4-base-carrier.kicad_pcb, rpi-cm4-base-carrier.kicad_sch, usbc_pwr.kicad_sch]
2024-01-29 PWR regs complete, EMI protection? LDO low noise passthrough??
    [5V_reg.kicad_sch, pwr_input.kicad_sch, rpi-cm4-base-carrier.kicad_pcb, usbc_pwr.kicad_sch]
2024-01-30 layout ready for review as major components now complete
    [SDCard.kicad_sch, pwr_input.kicad_sch, rpi-cm4-base-carrier.kicad_pcb]
2024-01-31 good routing and power plane progress, just some final plane progress remaining
    [Board_Edge_Connector.kicad_sch, rpi-cm4-base-carrier.kicad_pcb]
2024-02-03 fan control added to sch, layout 90% complete, awaiting review
    [LEDs.kicad_sch, SDCard.kicad_sch, USB2-HUB.kicad_sch, cm4-gpio.kicad_sch, fan_ctrl.kicad_sch, rpi-cm4-base-carrier.kicad_sch]
2024-02-03 convert IC refs to U refs and re-annotate, add fiducials and extra via stitching to layout
    [5V_reg.kicad_sch, Board_Edge_Connector.kicad_sch, HDMI.kicad_sch, LEDs.kicad_sch, SDCard.kicad_sch, USB2-HUB.kicad_sch, cm4-gpio.kicad_sch, cm4-high-speed.kicad_sch]
2024-02-07 design files exported ready for manufacture, LCSC part numbers added throughout the library
    [5V_reg.kicad_sch, BOM.csv, Board_Edge_Connector.kicad_sch, HDMI.kicad_sch, LEDs.kicad_sch, SDCard.kicad_sch, USB2-HUB.kicad_sch, bom.csv]
2024-02-12 files updated to kicad 8, 2x10 connector updated to correct origin
    [Board_Edge_Connector.kicad_sch]
2024-02-13 moved edge samtec edge connector to correct positioning
    [Board_Edge_Connector.kicad_sch]
