EarnshawSam/rpi-cm4-networked-carrier/(notices)

Notices in the files:
hardware/rpi-cm4-base-carrier/rpi-cm4-base-carrier - Backup.kicad_pcb:
creativecommons.org/licenses/by/4.0
License: CC BY-SA 4.0
hardware/rpi-cm4-base-carrier/cm4-high-speed.kicad_sch:
creativecommons.org/licenses/by-sa/4.0
parts and their libraries:
Copyright 2016 Accelerated Designs. All rights reserved.
